Jorjo80/Trabajo-ELAB/Fotos/WhatsApp Image 2018-12-17 at 20.18.28(1).jpeg

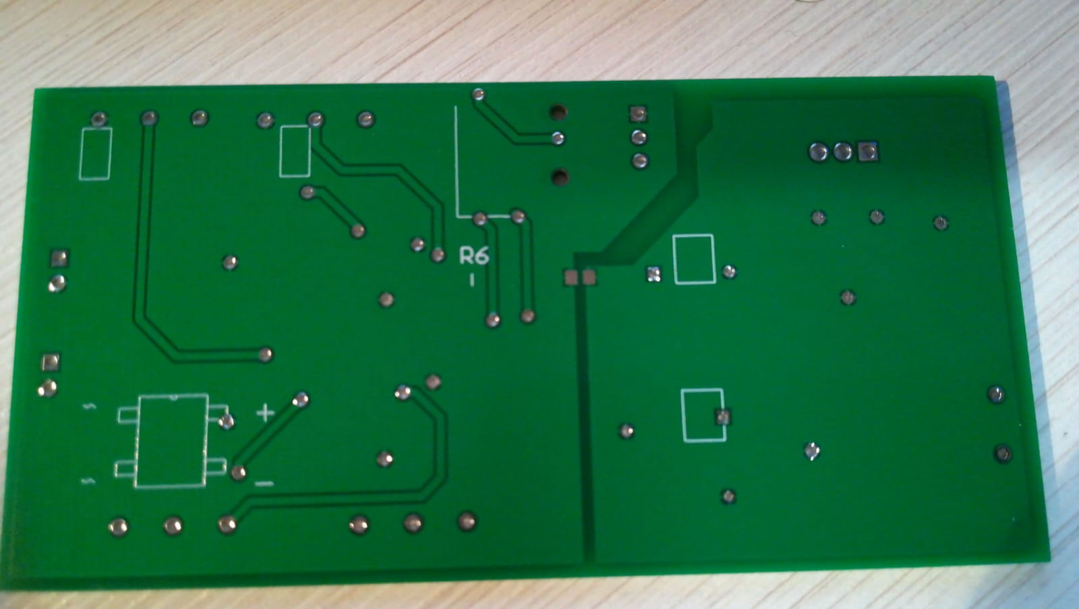
Fotos/WhatsApp Image 2018-12-17 at 20.18.28(1).jpeg
