Jorjo80/Trabajo-ELAB/Presentacion.pptx

## HOME MADE AUDIO AMPLIFIER

Jorge Contreras Ortiz
David Grande Gil

## Index

1. Aim of the Project
2. Amplifier Parts
3. Design Process
  1. Power Supply
  2. Audio Amplifier
  3. Layout
4. BOM and Ticket of materials
5. Testing

## Aim of the project

The aim of this project is to design and build a Stereo Audio Amplifier, using Altium Designer and following the next steps:
1. Schematics and Layout Design.
2. Selection and purchase of components.
3. Gerber files generation and PCB fabrication
4. Assembling the PCB.
5. Testing the PCB.

## Specifications

Power Supply System:
It will regulate from 230 Vac to 9 Vdc.
Current supply: 1 A minimum (calculated from Audio Amplifier specifications).
Audio Amplifier:
Stereo.
Guitar audio amplifier.
Mobile Phone Connection.

## Power Supply


## Audio Amplifier


## Initial Layout


## Final Layout


## BOM


## Ticket from Digikey


5 PCB Bought: 8,20 €; Customs: 16,45€; Total = 84,96 € for 5 PCB; Total €/PCB = 16,99€

## PCB Without Components


## PCB With Components


## Testing

Power Supply Testing.
Voltage measured at the output of the LDO: 9.2 V.
Ripple Voltage: 20 mV
Audio Amplifier Testing.
Good Quality with Jack 3.5 mm and music from Mobile Phone connected.
A little noise and distortions with Jack 6.35 mm and the Electric Guitar connected.
Checked that when is connected only the guitar and it is connected something to the 3.5 mm Jack, the Jack 6.35 is disconnected from the circuit.


## Questions and Comments
