Jorjo80/Trabajo-ELAB/Capturas/Bloques.PNG

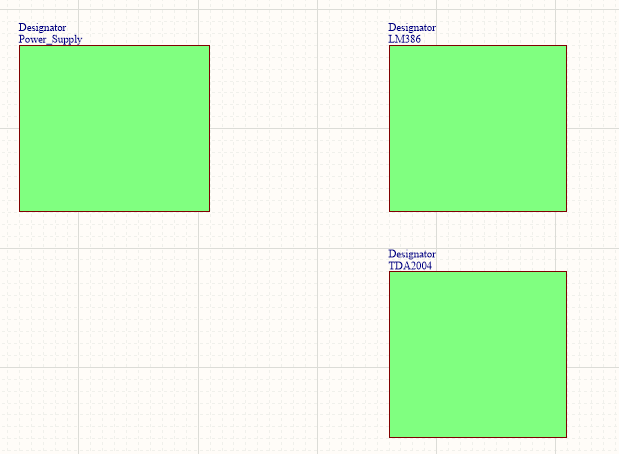
Capturas/Bloques.PNG
