Jorjo80/Trabajo-ELAB/Capturas/Circuito1_TDA.PNG

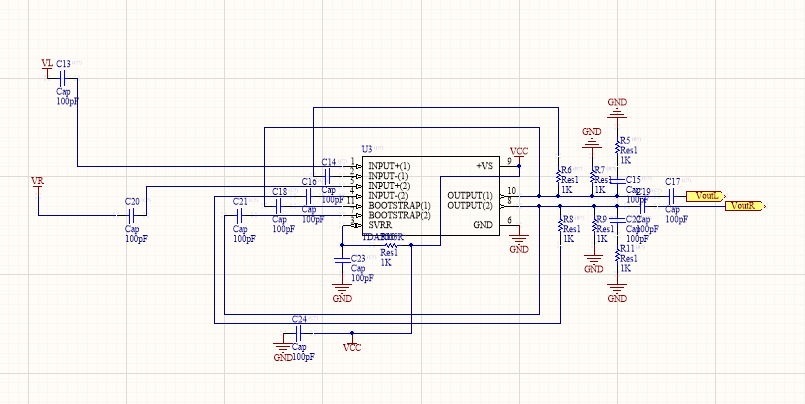
Capturas/Circuito1_TDA.PNG
