Jorjo80/Trabajo-ELAB/Capturas/Circuito_LM386_doble.PNG

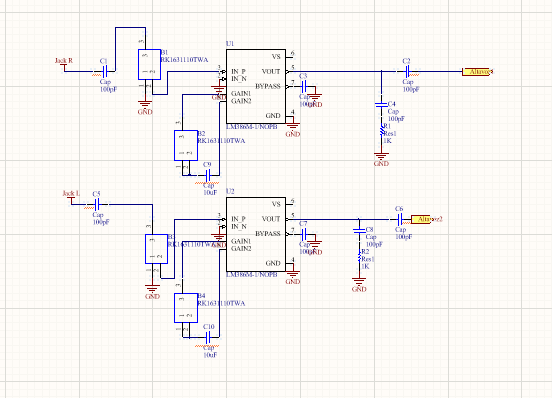
Capturas/Circuito_LM386_doble.PNG
