Jorjo80/Trabajo-ELAB/Capturas/circuitoPotencia.PNG

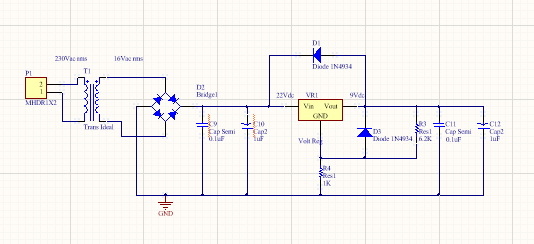
Capturas/circuitoPotencia.PNG
