Jorjo80/Trabajo-ELAB/PCB_ELAB/Project Outputs for PCB_Project1/BOM.xls

Comment | Description | Designator | Footprint | Value | Quantity | PN
Cap Semi | Capacitor (Semiconductor SIM Model) | C1, C5, C6, C7, C10, C11, C12 | C0805 | 100n, 47nF, 10uF | 7 | 08053C104KAT2A, 885012207043, CL21A106KOCLRNC
Cap Semi | Capacitor (Semiconductor SIM Model) | C2, C4, C8 | C1206 | 220nF, 10uF | 3 | C1206C224K4RAC7800, CL31B106MOHNNNE
Cap Pol3 | Polarized Capacitor (Surface Mount) | C3, C9 | C0805 | 220uF | 2 | 16YXJ220MT16.3X11
Cap Semi | Capacitor (Semiconductor SIM Model) C1608JB1V105K080AB, Capacitor (Semiconductor SIM Model) C0603T104J5RACTU, Capacitor (Semiconductor SIM Model) GRM188R6YA106MA73D | C13, C16, C17 | 1608[0603] | 1uF, 0.1uF, 10uF | 3 | CL10A105KL8NNNC, CC0603JRX7R9BB104, C2012JB1V106K125AC
Cap Pol1 | Polarized Capacitor (Radial) URS1V102MHD | C14, C15 | RB7.6-15 | 1000uF/35V | 2 | URS1V102MHD
S1BB-13-F | 100V 1 Amp General Purpose Rectifier | D1, D2 | DIOM505270X240 |  | 2 | S1BB-13-F
LED3 | Typical BLUE SiC LED IN-S85ATR | D3 | 6-0805_L |  | 1 | SML-H12P8TT86C
RPot | Potentiometer | G1, G2, V1, V2 | Potenciometer | 10K | 4 | P160KN-0QC20A10K
35RASMT4BHNTRX | Conn 3.5MM Stereo Jack F 3 POS Solder RA SMD 5 Terminal 1 Port T/R | J1 | SWITCHCRAFT_35RASMT4BHNTRX |  | 1 | 35RASMT4BHNTRX
Header 3 | Header, 3-Pin | J2 | HDR1X3 |  | 1 | 112BX
Speaker | Loudspeaker | LS1, LS2 | PIN2 |  | 2
External Trafo Used | Header, 2-Pin | P1 | PCBComponent_1 |  | 1
Res3 | Resistor | R1, R2 | SMD-0805-RES | 10 | 2 | RNCP0805FTD10R0
Res1 | Resistor ERJ-PA3J102V | R3 | J1-0603 | 1K | 1 | RC0603JR-071KL
Res3 | Resistor ERJ-PA3J102V, Resistor ERJ-PA3J622V | R4, R5 | J1-0603 | 1K, 6.2K | 2 | RC0603JR-071KL, ERJ-PA3J622V
Res3 | Resistor | R6 | 6-0805_N | 0 | 1 | CRCW08050000Z0EAC
LM386M-1/NOPB | Wide Input Voltage Low Power Audio Amplifier with Internal Gain 8-SOIC 0 to 70 | U1, U2 | SOIC127P600X175-8N |  | 2 | LM386M-1/NOPB
DF01S2 | DF01S Series 1.5 A 100 V 5 uA Surface Mount Bridge Rectifier -SDIP-4 | U3 | SOT508P985X260-4N |  | 1
LM317T |  | U4 | TO254P460X1020X1945-3P |  | 1 | LM317T
