Jorjo80/Trabajo-ELAB/PCB_ELAB/Project Outputs for PCB_Project1/PCB_Project1.xls

Description | Designator | Footprint | LibRef | PN | Quantity
Capacitor (Semiconductor SIM Model) | C1, C5, C6, C7, C10, C11, C12 | C0805 | Cap Semi | VJ0805Y104KXQCW1BC, C0805C473K3RACTU, C0805X106J8RACAUTO, VJ0805Y104KXQCW1BC, C0805X106J8RACAUTO, C0805C473K3RACTU, C0805X106J8RACAUTO | 7
Capacitor (Semiconductor SIM Model) | C2, C4, C8 | C1206 | Cap Semi | C1206C224KARACAUTO, TDK CGA5L1X8L1C106K160AC, C1206C224KARACAUTO | 3
Polarized Capacitor (Surface Mount) | C3, C9 | C0805 | Cap Pol3 | UKA1A221MED | 2
Capacitor (Semiconductor SIM Model) C1608JB1V105K080AB, Capacitor (Semiconductor SIM Model) C0603T104J5RACTU, Capacitor (Semiconductor SIM Model) GRM188R6YA106MA73D | C13, C16, C17 | 1608[0603] | Cap Semi | C1608JB1V105K080AB, C0603T104J5RACTU, GRM188R6YA106MA73D | 3
Polarized Capacitor (Radial) URS1V102MHD | C14, C15 | RB7.6-15 | Cap Pol1 | URS1V102MHD | 2
100V 1 Amp General Purpose Rectifier | D1, D2 | DIOM505270X240 | Diode 1N4002 | S1BB-13-F | 2
Typical BLUE SiC LED IN-S85ATR | D3 | 6-0805_L | LED3 | IN-S85ATR | 1
Potentiometer | G1 | Model Name | RPot | P160KNPD-0QC15A10K | 1
Potentiometer | G2, V1, V2 | PCBComponent_1 - duplicate | RPot | P160KNPD-0QC15A10K | 3
Conn 3.5MM Stereo Jack F 3 POS Solder RA SMD 5 Terminal 1 Port T/R | J1 | SWITCHCRAFT_35RASMT4BHNTRX | 35RASMT4BHNTRX |  | 1
Header, 3-Pin | J2 | HDR1X3 | Header 3 | 112BX | 1
Loudspeaker | LS1, LS2 | PIN2 | Speaker |  | 2
Header, 2-Pin | P1 | PCBComponent_1 | MHDR1X2 |  | 1
Resistor | R1, R2 | SMD-0805-RES | Res3 | SR732ARTTD10R0F | 2
Resistor ERJ-PA3J102V | R3 | J1-0603 | Res1 | ERJ-PA3J102V | 1
Resistor ERJ-PA3J102V, Resistor ERJ-PA3J622V | R4, R5 | J1-0603 | Res3 | ERJ-PA3J102V, ERJ-PA3J622V | 2
Resistor | R6 | 6-0805_N | Res3 | CRCW08050000Z0EAC | 1
Wide Input Voltage Low Power Audio Amplifier with Internal Gain 8-SOIC 0 to 70 | U1, U2 | SOIC127P600X175-8N | LM386M-1/NOPB | LM386M-1 | 2
DF01S Series 1.5 A 100 V 5 uA Surface Mount Bridge Rectifier -SDIP-4 | U3 | SOT508P985X260-4N | DF01S |  | 1
 | U4 | TO254P460X1020X1945-3P | LM317T | LM317T | 1
