Jorjo80/Trabajo-ELAB/PCB_ELAB/Project Outputs for PCB_Project1/Layout2.PDF

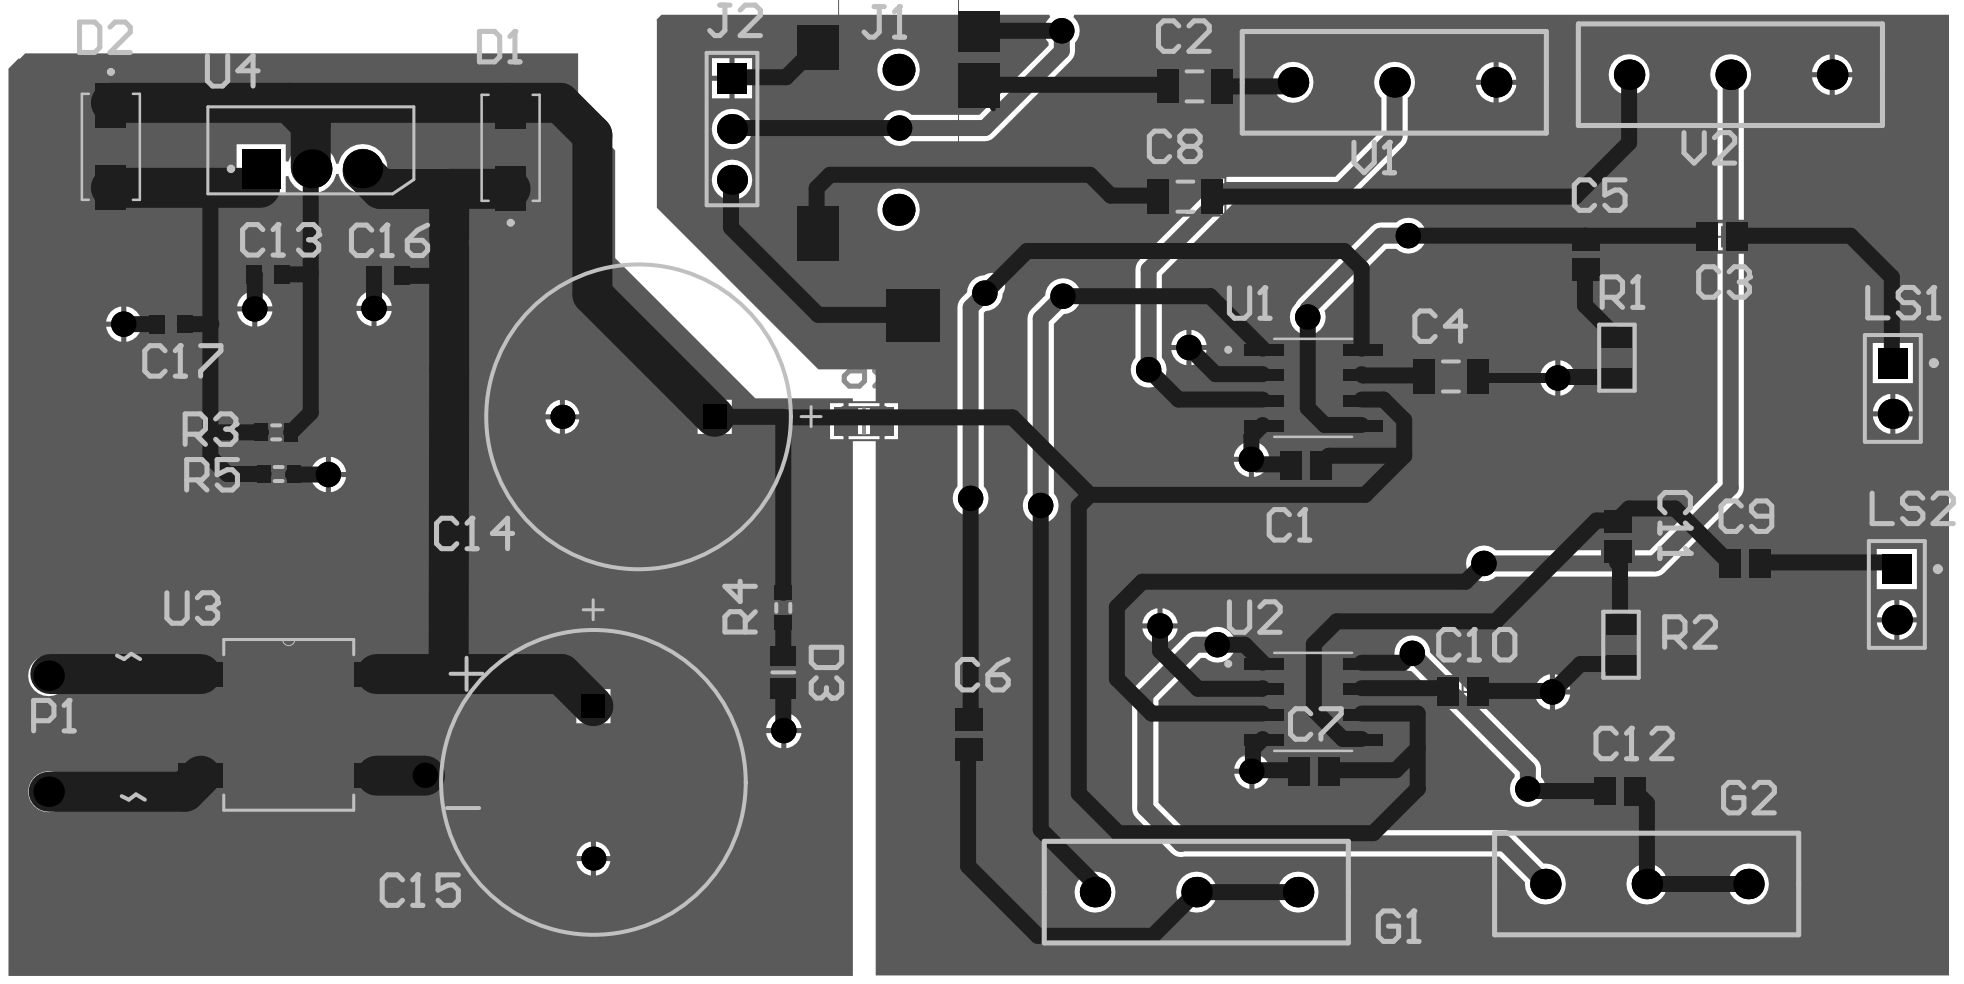
[picture p19: page 1]
