Jorjo80/Trabajo-ELAB/PCB_ELAB/Project Outputs for PCB_Project1/Esquemáticos.pdf

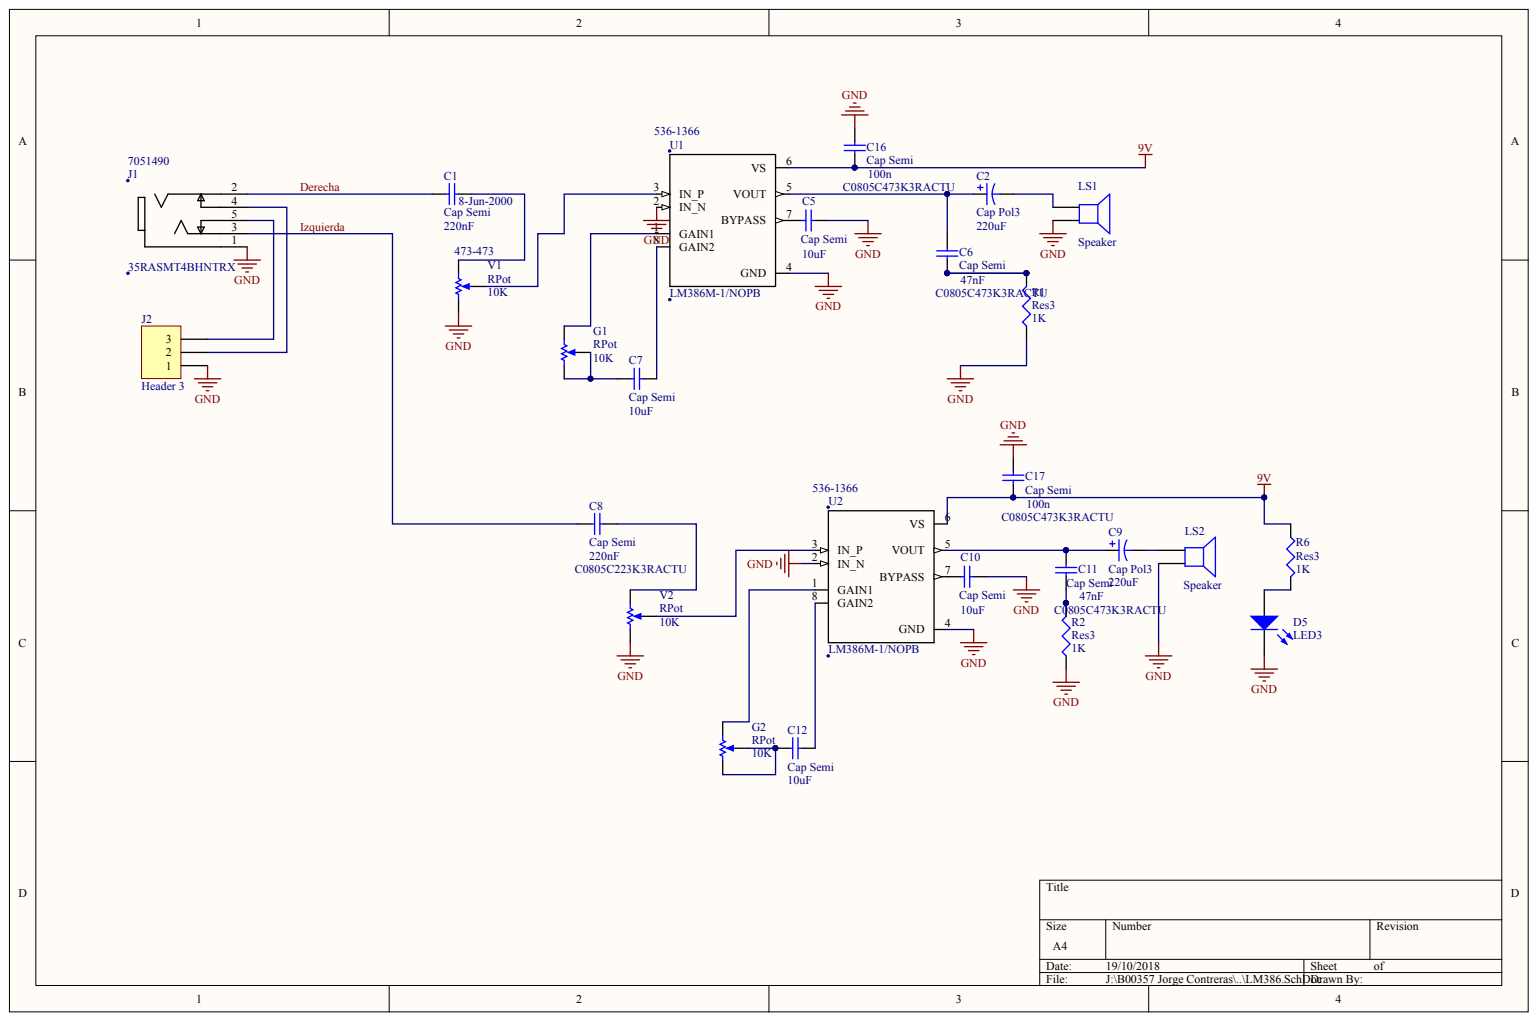
[picture p20: page 1]

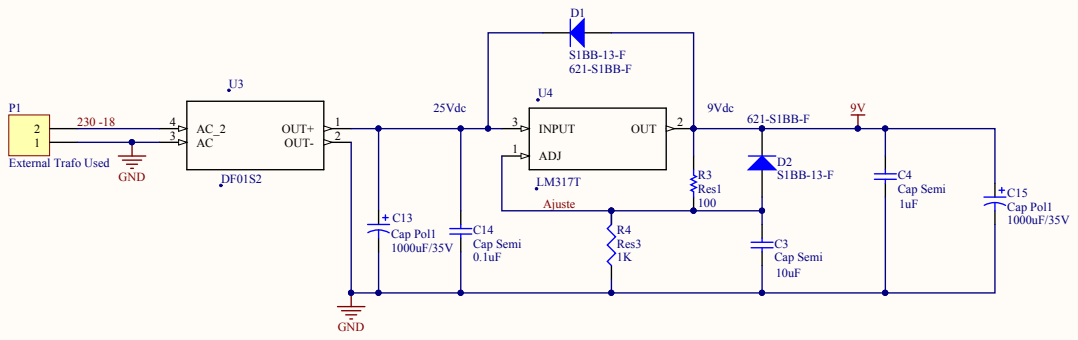
[picture p21: page 2]

ADJ

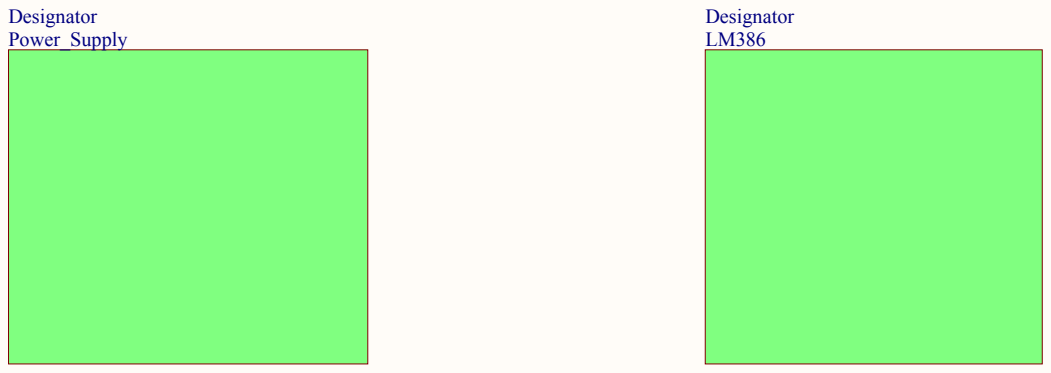
[picture p22: page 3]
