Jorjo80/Trabajo-ELAB/PCB_ELAB/Project Outputs for PCB_Project1/Layout.pdf

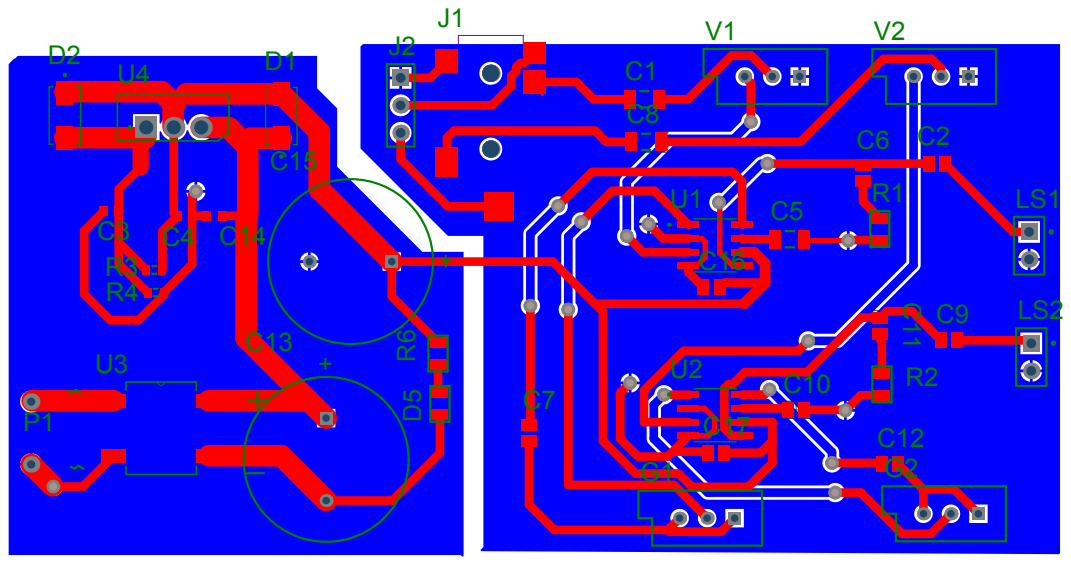
[picture p23: page 1]
