Jorjo80/Trabajo-ELAB/(list of files, drawings)

Other design files:
Footprints/Imported 35RASMT4BHNTRX.lia/35RASMT4BHNTRX.PcbLib
Footprints/Imported 35RASMT4BHNTRX.lia/35RASMT4BHNTRX.SchLib
Footprints/Imported (1) SOT508P985X260-4N.lia/SOT508P985X260-4N.PcbLib
Footprints/Imported DIOM505270X240.lia/DIOM505270X240.PcbLib
Footprints/Imported LM317T.lia/LM317T.PcbLib
Footprints/Imported LM317T.lia/LM317T.SchLib
Footprints/Imported LM386M-1_NOPB.lia/LM386M-1_NOPB.PcbLib
Footprints/Imported LM386M-1_NOPB.lia/LM386M-1_NOPB.SchLib
Footprints/Imported s1bb-13-f.lia/s1bb-13-f.PcbLib
Footprints/Imported SOT508P985X260-4N.lia/SOT508P985X260-4N.PcbLib
Footprints/Imported TDA2005R.lia/TDA2005R.PcbLib
Footprints/Imported TDA2005R.lia/TDA2005R.SchLib
Footprints/RK1631110TWA/Altium/Imported PADS Libraries.PrjPcb/PADS Libraries.PrjPcb
Footprints/RK1631110TWA/Altium/Imported PADS Libraries.PrjPcb/RK1631110TWA.PcbLib
Footprints/RK1631110TWA/Altium/Imported PADS Libraries.PrjPcb/RK1631110TWA.SchLib
Footprints/s1bb-13-f/Imported DIOM505270X240.lia/DIOM505270X240.PcbLib
PCB_ELAB/Conectores_Trafo.PcbLib
PCB_ELAB/LM386.SchDoc
PCB_ELAB/PCB1.PcbDoc
PCB_ELAB/PCB_Project1.PrjPCB
PCB_ELAB/Power_Supply.SchDoc
PCB_ELAB/Sheet1.SchDoc
