Jorjo80/Trabajo-ELAB/(commit log)

2018-09-23 Files organization
    [LM386.SchDoc, PCB_Project1.PrjPCB, Power_Supply.SchDoc, Sheet1.SchDoc, TDA2004.SchDoc]
2018-09-23 Sch improvement
    [LM386.SchDoc, POWER SUPPLY.SchDoc, Power_Supply.SchDoc, Sheet1.SchDoc]
2018-09-23 Añadir capturas esquemáticos
    [PCB_Project1.PrjPCB, TDA2004.SchDoc]
2018-09-27 actualizacion esquemáticos
    [LM386.SchDoc, PCB_Project1.PrjPCB, Power_Supply.SchDoc, Sheet1.SchDoc]
2018-09-30 añadir condensador electrolítico
    [LM386.SchDoc, PCB_Project1.PrjPCB, POWER SUPPLY.SchDoc, Power_Supply.SchDoc, Sheet1.SchDoc, TDA2004.SchDoc]
2018-10-02 Terminado Sch Lm386
    [LM386.SchDoc]
2018-10-03 Update power supply schematic
    [Power_Supply.SchDoc]
2018-10-03 minijack añadido
    [35RASMT4BHNTRX.PcbLib, 35RASMT4BHNTRX.SchLib, LM386.SchDoc]
2018-10-09 Revisión día 4/10/2018
    Revision con Miroslav, enseñar esquemático.
    [LM386.SchDoc, PCB_Project1.PrjPCB, Power_Supply.SchDoc, Sheet1.SchDoc]
2018-10-14 POWER SUPPLY FOOTPRINTS AND PARTS
    [Power_Supply.SchDoc]
2018-10-14 añadido supplier link, etapa de potencia
    package S1BB-F
    [Power_Supply.SchDoc]
2018-10-14 Link Rs
    Links RS partes amplificacion
    [LM386.SchDoc, PCB_Project1.xls]
2018-10-14 Añadir PN componentes
    [LM386.SchDoc]
2018-10-15 Añadir Speaker
    Simbolos Speaker en vez de conectores
    [LM386.SchDoc, PCB1.PcbDoc, Power_Supply.SchDoc]
2018-10-15 Archivo PCB con forma 10x10
    [LM386.SchDoc, PCB1.PcbDoc, PCB_Project1.PrjPCB, Power_Supply.SchDoc]
2018-10-16 Añadidas las huellas que faltaban
    [LM317T.PcbLib, LM317T.SchLib, PCB1.PcbDoc, PCB_Project1.xls, Power_Supply.SchDoc, SOT508P985X260-4N.PcbLib, s1bb-13-f.PcbLib]
2018-10-16 Arreglo huella diodos
    [DIOM505270X240.PcbLib, LM386.SchDoc, PCB1.PcbDoc, Power_Supply.SchDoc, s1bb-13-f.PcbLib]
2018-10-16 Colocados Componentes en PCB
    [LM386.SchDoc, PCB1.PcbDoc, Power_Supply.SchDoc]
2018-10-17 Route power supply
    [PCB1.PcbDoc]
2018-10-17 Añadir SMD footprints
2018-10-18 Roteado Audio Parte 1
    [PCB1.PcbDoc]
2018-10-18 2 gnd
    [PCB1.PcbDoc, Power_Supply.SchDoc]
2018-10-18 Routeado todo
    A falta de Condesandores de desacoplo
    [LM386.SchDoc, PCB1.PcbDoc]
2018-10-18 PCB + Desacoplo
    [LM386.SchDoc, PCB1.PcbDoc]
2018-10-23 Enseñado a Miroslav
    [PCB1.PcbDoc, PCB_Project1.PrjPCB, TDA2004.SchDoc]
2018-10-23 Añadidos Vias GND
    [PCB1.PcbDoc, PCB_Project1.PrjPCB]
2018-10-24 POWER PART - UPDATE SCHE AND PCB FILES
    [LM386.SchDoc, PCB1.PcbDoc, POWER SUPPLY.SchDoc, Power_Supply.SchDoc]
2018-10-24 Arreglos Jorge
    [Conectores_Trafo.PcbLib, LM386.SchDoc, PCB1.PcbDoc]
2018-10-24 Arreglar R 0 Ohmios
    [LM386.SchDoc, PCB1.PcbDoc, Power_Supply.SchDoc]
2018-10-30 Ficheros Gerber
    ficheros gerber
    [PCB1.GBL, PCB1.GBO, PCB1.GBP, PCB1.GBS, PCB1.GKO, PCB1.GM1, PCB1.GTL, PCB1.GTO]
2018-11-11 Add part umbernames
    [PCB1.PcbDoc, Power_Supply.SchDoc]
2018-11-11 PN Analogicos
    [LM386.SchDoc, PCB1.PcbDoc]
2018-11-12 Añadido PN tántalo
    C3 y C9
    [LM386.SchDoc]
2018-11-12 Excel PartNumbers
    [LM386.SchDoc, partnumbers.xlsx]
2018-11-15 Creado BOM
    [BOM.xls, LM386.SchDoc, PCB_Project1.PrjPCB, PCB_Project1.xls, Power_Supply.SchDoc, Sheet1.SchDoc, partnumbers.xlsx]
2018-11-18 Carrito + PN
    [BOM.xls, LM386.SchDoc, PCB_Project1.PrjPCB, carrito.xlsx, partnumbers.xlsx]
2018-11-19 Carrito mouser Modificado
    Había solo 5 lm386, necesitamos 10
    [Mouser.xls]
2018-12-01 Empezando el informe
    [DigiKey.xlsx]
2018-12-18 Informe + BOM
    [57423655.xlsx, BOM.xls, DigiKey.xlsx, LM386.SchDoc, PCB_Project1.PrjPCB, Power_Supply.SchDoc, carrito.xlsx]
2018-12-19 Informe y ppt
    [57423655.xlsx, BOM.xls, Conectores_Trafo.PcbLib, LM386.SchDoc, Mouser.xls, PCB_Project1.PrjPCB, partnumbers.xlsx]
2018-12-19 Edit final file of presentation power point
